Tigrisz/LLM-Accelerator/docs/b_handoff_2026-10-17.md

# A/B 联调交接：第 7 天里程碑

日期：2026-10-17。

## B 已完成内容的核对

仓库：https://github.com/Tigrisz/LLM-Accelerator

基准提交：`d8398373d69dd371df55ec7b69df46d7db10b9b7`（2026-10-13）。

- 已发布 V1 配对流协议、Python INT4 打包/解包、分组整数 Golden、确定性向量生成。
- 已提供 3 个指定用例及 case_001，含实际二进制、NumPy 答案和流元数据。
- 已提供 memory_model、weight_reader、activation_cache、paired_input_stream。
- 原仓库 9 项 Python 测试可通过，但干净检出需要先建立 tmp 目录。
- 原仓库未提供可运行 HDL 联调 Testbench；Makefile 的 test-integration 只运行 Python。
- 尚无 CPU BFM、寄存器控制器、真实模型提取脚本、双缓冲或实际带宽扫描。

## 本次 A 推进

1. 接入 B 的真实文件格式，校验 padded_K、文件长度、零填充、NumPy dtype/shape 和流元数据。
2. 核心测试直接对照 B 的 expected_partial.npy；16/32 路各运行连续与随机停顿模式。
3. 接通 memory_model → weight_reader + activation_cache → paired_input_stream → gemv_core。
4. 激活仅装载一次、逐行重放；逐 beat 核对权重、激活、标签、组标记及每组结果。
5. 结果完成以最后输出握手为准，测试末尾结果长时间阻塞；reader_done 不作为任务完成。
6. 添加容量、错误事务、复位重启回归，修复联调实际发现的问题，严格 lint 通过。

## 测试证据

| 层级 | 测试量 | 结果 |
|---|---|---|
| 原 A 基础回归 | 每并行度 4096 个乘法组合、139 个功能用例 | PASS |
| B Python 回归 | 9 项 | PASS |
| B Golden → A 核心 | 107 个向量 × 2 种并行度 × 2 种流模式 | PASS |
| B 存储链路 → A 核心 | 107 个向量 × 2 次连续任务，固定 32 路 | PASS |
| 定向边界 | 缓存满、4 个非法配置、2 种中途复位并重启 | PASS |
| lint | A 核心 16/32 路及完整 32 路链路，-Wall | PASS |

107 个向量 = 4 个 B 交付 + 100 个种子 + K=2048/6144/8192 三个长向量。
原始日志：build/b_core_results.log、build/b_integration_results.log。
本次只有合成整数向量；不能把长向量通过描述为真实模型切片通过。

## B 模块修复及原因

### activation_cache：容量判断混用了元素和 beat

原式 `load_ptr + BYTE_COUNT <= MAX_K` 中 load_ptr 是 beat 索引，MAX_K 是元素数。
在 MAX_K=8192 时装满 256 个 32 元素 beat 后，旧代码仍接受后续输入，静默丢失越界内容。
定向测试原版报 `FAIL cache accepts beyond MAX_K cycle=257`。
现在按 `load_ptr < MAX_K/LANES` 判断容量，并明确 loaded_k 加法宽度。
修复后容量测试通过。完整物理 beat 装载要求 MAX_K 至少容纳 padded_K。

### weight_reader：错误响应没有完成握手

旧代码见 rd_error 即进入 S_ERROR，且 rd_data_ready 依赖权重/激活消费者。
因此错误响应可能永远留在 memory_model 的 S_SEND 中。
未对齐地址且不提供激活的定向测试报 `FAIL error response not drained cycle=101`。
现在错误响应不依赖消费者 ready，等待 rd_data_valid && rd_data_ready 后再进入 S_ERROR。
错误仍保持 sticky，恢复仍需 reset，保持 B 原版约定。

### memory_model 与 lint

显式扩展地址/长度加法，限定数组索引位宽，移除未使用的 padded_k。
合法请求字节数已对齐，直接整除获得 beat 数，避免先加 DATA_BYTES-1 的溢出。
主机写地址先检查基地址在范围内，避免极大地址加偏移回绕。
不使用 -Wno-fatal 作为最终通过条件。最初只为复现原版问题临时使用该选项。

具体差异见 b_memory_fixes.patch（可在 B 仓库用 git apply --check 预检）。

## 进度判定

已达到 D7/M2：第一条“内存 → 计算 → 与独立 Golden 匹配”链路跑通。
A 的 D8/D9 所需尾组、反压、连续数据流和复位已有覆盖。
这不等于系统 D8/D9 完成：目前没有寄存器配置、CPU BFM 或完整任务 FSM。

## 下一步交给 B

- 合入 A 的 rtl/compute、联调测试和上述 B 修复，保留配对握手及 padded_K 规则。
- 按第 8 天计划实现控制寄存器、CPU BFM、任务 FSM；done 必须等待结果接收。
- 检查 k_elems/padded_K 是否超出缓存容量（联调夹具设 MAX_K=8192）。
- 默认先保持 32 路；16 路核心已验证，但固定 128-bit 存储总线到 64-bit 核心需宽度适配。
- 提供真实目标模型 8/16 行 × 完整 K 的权重切片及同格式 Golden，再进行真实数据验收。
- 后续带宽扫描需要明确限速机制；当前模型状态机和随机停顿不等于已实现 4/8/16 GB/s 三档实验。

A 随后负责接新控制器后的回归、真实切片核验、必要的计算侧时序/吞吐优化。
实际 FPGA 资源与 Fmax 仍需器件和厂商综合工具。
