Tigrisz/LLM-Accelerator/(list of files, cad)

Other CAD files:
evidence/a_multigroup_pds/2026-10-21/k256/pds/a_multigroup_k256_uart_board_top_prr.prt
