Tigrisz/LLM-Accelerator/docs/compute_benchmark.md

# 计算核心初步周期对比

2026-10-11，Verilator 4.038，精确整数随机矩阵，seed=20261011。
N=8、K=2048、G=128，相同逻辑权重与激活，无输入停顿、无输出反压。
周期统计从发送首 beat 开始，到最后一个结果被接收为止；不计复位及数据生成。

| LANES | 输入 beat | 输出组数 | 周期 | 逻辑权重字节 | MAC/周期 |
|---|---:|---:|---:|---:|---:|
| 16 | 1024 | 128 | 1025 | 8192 | 15.984 |
| 32 | 512 | 128 | 513 | 8192 | 31.938 |

MAC 总量为 N*K=16384；最后结果接收带来一个排空周期。
32 路在这组相同无停顿数据上周期约减半。
这是核心级周期结果，不含 B 的存储、激活装载、软件缩放或控制开销。
它不表明两种并行度在 FPGA 上能达到相同频率，也不代表真实模型 Token/s。

## 假设时钟预算

若假设 f=200MHz，16/32 路理论权重输入需求为 1.6/3.2 GB/s；
实际核心本次相应权重字节/周期为 8192/1025 与 8192/513。
这只是时钟假设下的计算接口需求，不是实际 DDR 测量。
没有综合工具与器件约束，当前不能报告 Fmax、LUT 或 DSP。

随机回归也输出 input_idle/output_stall 计数，但它们包含不同测试与复位场景，
不能用于单独的并行度性能对比，也不代表 memory_stall。
存储带宽限制、双缓冲和系统等待比例需与 B 的完整链路一起实验。

复现：`make test-compute lint`。原始输出保存在 `build/compute_regression.log`。
