Tigrisz/LLM-Accelerator/fpgatest/qwen_slice/prj/place_route/fixed_slice_qwen_demo_top_timing_summary_after_hold_fix.txt

Design Summary : All Constraints Met.

Setup Summary(Slow Corner):
****************************************************************************************************
                                                                          TNS Failing      TNS Total
 Launch Clock           Capture Clock              WNS(ns)     TNS(ns)      Endpoints      Endpoints
----------------------------------------------------------------------------------------------------
 clk                    clk                         24.418       0.000              0            812
====================================================================================================

Hold Summary(Slow Corner):
****************************************************************************************************
                                                                          THS Failing      THS Total
 Launch Clock           Capture Clock              WHS(ns)     THS(ns)      Endpoints      Endpoints
----------------------------------------------------------------------------------------------------
 clk                    clk                          0.194       0.000              0            812
====================================================================================================

Recovery Summary(Slow Corner):
****************************************************************************************************
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
----------------------------------------------------------------------------------------------------
====================================================================================================
