Tigrisz/LLM-Accelerator/(commit log)

2026-10-17 修复激活缓存循环变量多驱动
2026-10-19 Add 16-lane Qwen FPGA slice and board artifacts
2026-10-20 多组模型切片
2026-10-21 Document pinned Qwen checkpoint and verified UART project reproduction
2026-10-21 Keep UART lint compatible with Verilator 4.038
2026-10-21 Audit board UART captures and validate groupwise dequantization
2026-10-21 Reuse B ROM bootstrap and verify pinned provenance in UART acceptance
2026-10-22 K256、K384用例验证
2026-10-22 浮点数据验证
2026-10-22 Independently accept multi-group board captures and Qwen float metrics
